rn3kk/RemoteTubeAmplifaier/py_server/ClientThread.py

import json
import logging
import time
from datetime import datetime

import errno
import socket
import sys
import traceback
import re
from threading import Thread

from common.common import *
from py_server import states
from py_server.TRX_State_TCP_Client import TRX_State_TCP_Client

log = logging.getLogger('root')

PORT_AUDIO = 6992


class ClientThread(Thread):
    __terminate = False

    def __init__(self, conn, addr, mech1, pins):
        log.debug('ClientControlThread()')
        Thread.__init__(self)
        self.__conn = conn
        self.__set_keep_alive(self.__conn)
        self.__conn.settimeout(0.1)
        self.__autorisation_token = ''
        self.__autorised = False
        self.__connection_time = datetime.now()
        self.__addr = addr
        self.__mech1 = mech1
        self.__mech2 = mech1
        self.__pins = pins
        self.__edit_mode = 0
        self.__trx_state_informer = TRX_State_TCP_Client.getInstance()

    def __del__(self):
        print('~ClientControlThread()')

    def run(self):
        log.debug('ClientControlThread is run')
        while not self.__terminate:
            time.sleep(0.001)
            if not self.__autorised \
                    and ((datetime.now() - self.__connection_time).total_seconds() * 1000 > 1000):
                log.error('client autorisation error')
                self.__conn.close()
                self.__client_disconnected()
                break
            try:
                data = self.__conn.recv(128)
                if self.__terminate:
                    break
                if len(data) == 0:
                    self.__conn.close()
                    self.__client_disconnected()
                    break
                s = re.compile(b"{.*?}")
                m = s.search(data)
                while m:
                    try:
                        data = data.replace(m.group(), b'')
                        cmd = json.loads(m.group())
                        if self.__autorised:
                            c = cmd[COMMAND]
                            if c == CMD_CHANGE_ANGLE_MECH1:
                                angle = int(cmd[VALUE])
                                self.__mech1.set_angle(angle)
                            elif c == CMD_CHANGE_ANGLE_MECH2:
                                angle = cmd[VALUE]
                                self.__mech2.set_angle(angle)
                            elif c == CMD_CHANGE_MANUAL_MECH1:
                                self.__mech1.set_manual_mode()
                            elif c == CMD_CHANGE_MANUAL_MECH2:
                                self.__mech2.set_manual_mode()
                            elif c == CMD_CHANGE_PWR:
                                self.__pins.change_pwr()
                            elif c == CMD_CHANGE_RELAY:
                                self.__pins.set_relay_number(int(cmd[VALUE]))
                            elif c == CMD_RESET_PROTECTION:
                                self.__pins.reset_protection()
                            elif c == CMD_CHANGE_BANDPATH:
                                self.__pins.change_bandpath()
                            elif c == CMD_EDIT_MODE:
                                if self.__trx_state_informer.trx_found == 0:
                                    self.__edit_mode = 0
                                    d = Protocol.createCmd(FROM_PA_EDIT_MODE, self.__edit_mode)
                                else:
                                    self.__edit_mode = int(not self.__edit_mode)
                                    log.debug(f'edit mode is {self.__edit_mode}')
                                    d = Protocol.createCmd(FROM_PA_EDIT_MODE, self.__edit_mode)
                                self.__conn.send(d)
                                if self.__edit_mode == 0:
                                    self.__mech1.disable_manual_mode()
                                else:
                                    freq = round_freq(self.__trx_state_informer.freq)
                                    self.__trx_state_informer.set_trx_freq(freq)
                            elif c == CMD_FREQ_UP:
                                if self.__edit_mode == 1:
                                    freq = self.__trx_state_informer.freq
                                    print('freq_trx = ', freq)
                                    freq = round_freq(self.__trx_state_informer.freq) + TUNE_STEP
                                    print('freq_round = ', freq)
                                    self.__trx_state_informer.set_trx_freq(freq)
                            elif c == CMD_FREQ_DOWN:
                                if self.__edit_mode == 1:
                                    freq = round_freq(self.__trx_state_informer.freq) - TUNE_STEP
                                    if freq < 0:
                                        freq = 0
                                    self.__trx_state_informer.set_trx_freq(freq)
                        elif cmd[COMMAND] == CMD_AUTORISATION_TOKEN:
                            print('to server autoorised')
                            self.__autorisation_token = cmd[VALUE]
                            self.__cleint_autorised()
                            log.info('client autorisation OK')
                        else:
                            log.warning('Unknown command ' + data.decode())
                    except:
                        print('error in data', data)
                    finally:
                        m = s.search(data)

            except socket.timeout:
                pass
            except Exception:
                print(traceback.format_exc())
                self.__conn.close()
                self.__conn = None
                log.error('close connection')
                self.__client_disconnected()
                break

            try:
                if self.__autorised:
                    pins_d = self.__pins.get_data()
                    if pins_d:
                        self.__conn.send(pins_d)
                    trx_state = self.__trx_state_informer.get_data()
                    if trx_state:
                        self.__conn.send(trx_state)
                    mech1_d = self.__mech1.get_data()
                    if mech1_d:
                        print('Send_mech', mech1_d)
                        self.__conn.send(mech1_d)
            except socket.timeout:
                pass
            except socket.error as e:
                log.error('socket.error' + str(e))
                if e.errno == errno.ECONNRESET:
                    self.__conn.close()
                    self.__conn = None
                    log.error('close connection')
                    self.__client_disconnected()
                    break
                else:
                    raise
        if self.__conn:
            self.__conn.close()
        self.__trx_state_informer.resetInstance()
        print('ClientControlThread loop is end')

    def __cleint_autorised(self):
        addr = self.__addr
        log.info('input connection from  ' + addr[0] + ' autorised')
        self.__autorised = True
        self.__pins.client_connected()
        self.__mech1.client_connected()
        self.__trx_state_informer.send_current_state()
        d = Protocol.createCmd(FROM_PA_EDIT_MODE, self.__edit_mode)
        self.__conn.send(d)

    def __client_disconnected(self):
        addr = self.__addr
        self.__edit_mode = False
        log.info('disconnected ' + addr[0])

    def __set_keep_alive(self, sock, after_idle_sec=1, interval_sec=5, max_fails=6):
        sock.setsockopt(socket.SOL_SOCKET, socket.SO_KEEPALIVE, 1)
        sock.setsockopt(socket.IPPROTO_TCP, socket.TCP_KEEPIDLE, after_idle_sec)
        sock.setsockopt(socket.IPPROTO_TCP, socket.TCP_KEEPINTVL, interval_sec)
        sock.setsockopt(socket.IPPROTO_TCP, socket.TCP_KEEPCNT, max_fails)

    def set_terminate(self):
        self.__terminate = True
