rn3kk/RemoteTubeAmplifaier/(commit log)

2020-04-17 -перемещение файло
2020-04-17 Подготовка к загрузке позиций частота полождения из файла
2020-04-17 Сделана загрузка точек из файла
2020-04-17 Добавлено генерация сигнала при изменении частоты
2020-04-17 Добавил пустой класс
2020-04-21 -добавлен файл для задания кофигурации, хрангения настроек,хранения точек, его парсинг -добавлен код по взаимодейтсвию с мотором (работает)
2020-04-28 В конфиг добавил разделы для мехадуино устройств
2020-04-30 -удалил лишние сущности, упростил систему -изменил конфиг
2020-04-30 начал делать gui
2020-05-30 -сделан парсинг чатоты, номера слайса, активного слайса, ТХ -не корректно работает парсинг, нужно удалить \n в передаваемом на парсинг массиве и удалить все что после него
2020-06-01 - сузил панель со слайсами - работает парсинг частоты, активного слайса, ТХ
2020-06-08 -добавил кнопки перестройки частоты -добавил кнопку Tune
2020-06-10 -добавлены в конфиг список частот -не работает задание позиционирования (нужно переделать на сигнал слоты) -частота передается четерь int
2020-06-14 -мехадуино панель теперь управляет мотором
2020-06-14 -протянул название в панель -изменил стиль панели
2020-06-16 -добавил разсылку событий о режиме настроек
2020-06-17 -когда включаем tune mode частота TX слайса автоматом подгоняется под сетку с шагом 25 кгц. -работает перестройка частоты трансивера по кнопкам < и >
2020-06-18 -сделано сохранение значение позиция + частота ( работает криво, нужно разбираться)
2020-06-20 -ввел режим tune mode -убрал привязку ГУИ к трансиверу -мехадуино ходит следом за частотой флекса -добавил включение/отключение крутилки для перестройки мехадуино в зависимости от режима ( tuneMode)
2020-07-11 -добавлен функционал для добавления протоколов других трансиверов (создан интерфейс) -добавлен пустой класс для поддкржки FT-857
2020-07-17 -добавлены новые секции в конфиг (но не сделан их парсинг) -добавлена пустая фабрика для получения интерфейса радио
2020-07-17 -напи сана фабрика для создания трансивера
2020-07-22 -Переход на создание радио через фабрику
2020-07-25 -сделано получение частоты от ft857 -частота пока не парсится, есть предположение что порядок байт приходит обратный
2020-07-26 -поддержана работа трансивера yaesu ft-857
2020-08-18 -сделал поддержку ручной настройки Mechaduino -ручное задание градусов не совпадает с заданием через указание точки (нужно править прошивку Mechaduino)
2020-12-05 работа на сервером;
2020-12-05 работа над моделью
2020-12-07 работа над протоколом
2020-12-26 Работа над сервером -поддаржан многоклиентский режим подключения
2020-12-26 Работа над сервером -добавлена проверка токена во входящих запросах
2020-12-26 Работа над сервером -после подключения сразу отдается модель
2020-12-26 Работа над клиентом -добавлена пустая форма
2020-12-29 Перенос файлов
2021-01-27 Работа над сервером -работает обмен данными
2021-04-07 Работа над широковещательной рассылкой инфы о себе. Не работает прием сообщений(принимает только первую датаграмму и все)
2021-04-08 Работает прием бродкастов
2021-04-10 Работа над рассылкой событий о появлении ум в локалке и приеме их на программе клиенте. Работает.
2021-04-12 Концепция такова, что наружу из локалки эти порты не высовываем, потому доверяем всем. Для подключения извне будет сервер.
2021-04-12 Работает автоматическое удаление услилтеля из списка у клиента, если его серверная часть выключилась
2021-04-13 Работа над методами подключения из клиента к серверу
2021-04-17 Работа над протоколом Нужно подумать как быть с передачей позиции для мехадуино
2021-04-18 Рабортает оповещение клиента если модель изменилась
2021-05-14 Работает подключение из клиента к серверу
2021-05-24 Работает получение частоты от сервера
2021-05-25 Работает передача и изменение состояния кнопки вклчения
2021-05-27 Работает передача состояние мехадуино от сервера клиенту
2021-05-28 Добавляются MechPanel на форму автоматически
2021-05-28 Работа над управлением мехадуино
2021-05-29 Разделил модель на две: BackModel, FrontModel. Общий для них класс Model хранит все состояния, а наследники реализуют поведение
2021-05-30 Наполнил функционалом BackModel,FrontModel
2021-06-24 Введение новой концепции моделей
2021-06-25 Работает подключение от клиента серверу с новыми моделями
2021-06-25 Поправил отображение кнопки Tune
2021-06-25 Работает -передача команды включения -закрытие формы если сервер отвалился -поправлены модели -работает нажатие кнопки включить
2021-06-28 -переделан механизм генерации соьытий при нажатии клавиш pwr tune mode -работает передача tunemode pwr
2021-06-28 -работает отправка новой позиции мехадуино на сервер
2021-06-29 -ведена сущность Mechaduino -в связи с этим изменились сигналы слоты везде
2021-06-29 -Добавил конструктор копирования в Mechaduino
2021-06-30 -Работает ГУИ по изменению мехадуино, включения, изменению режима тюне може , ручного изменения мехадуино
2021-06-30 -добавлен пустой класс для обслуживания пинов
2021-06-30 -убраны не используемые слоты
2021-07-05 Работает проброс данных на сервере через сигналы
2021-12-28 -убраны warnings
2021-12-28 Работа над сервером(конроллером) -удалено не нужное -упрощение кода: жестко прописываем два мотора
2021-12-29 -жестко прописаны два мехадуино на форме у клиента -при подключении клиента, происходит передача статуса усилителя -наведение порядка по коду клиента
2021-12-29 -работает проброс состояние кнопки включения на сервер и отрисовка состояния на клиенте
2022-03-16 Начат проект на питоне
2022-03-18 Создание каркаса сервера
2022-03-18 Создание GUI клиента
2022-03-18 -клиент подключается к серверу и авторизуется
2022-03-18 -мотор управляется с клиента( только градусы)
2022-03-19 добавил файлы
2022-03-19 - работа над GIU - работа над пинами
2022-03-19 - работа над пинами
2022-03-19 - промежуточный коммит
2022-03-21 - работает задание угла из клиента - работает задание ручного режима из клиента -работает сброс защиты -работает кнопка включения
2022-03-21 - работает задание реле - работает отображение какое релде там включено (после конекта)
2022-03-21 - работает режим включения/отключения редактирования параметров УМ
2022-07-02 - сервер подключается к радио и получает: частоту, включено или выключено радио
2022-07-07 Работает взаимодействие клинета и сервера - вкл откл -получение статуа радио и частоты -сброс защит -переключение bandpath
2022-07-07 - есть косяки управления мехадуино при быстрой перестройке на сервере
2022-07-08 - сделана остановка потокос по Ctrl-C - убрано спамящее логгирование - добавлено логгирование
2022-07-08 - добавлено логгирование
2022-07-11 - удаление файлов срр - работа над перестройкой частоты трх для настройки
2022-07-12 - работает перестройка по частоте для настройки радио
2026-10-13 - прошивка esp32: веб-морда с таблицей выбора частот - при выборе частоты меняется положение сервопривода - описание задачи в CLAUDE.md
2026-10-13 - сервоприводы STS3215: КПЕ и вариометр - режим настройки на веб-странице с сохранением положений для частоты - хранение настроек на microSD - переключатель БМЗ на 5 положений через реле - на страниц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
2026-10-14 - хранение настроек во внутренней flash-памяти вместо microSD - выгрузка и загрузка таблицы настроек через веб-страницу - сервисный режим: поиск сервоприводов на шине и смена ID - чтение ответов серв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
2026-10-14 - модуль реле: включение УМ, плавный пуск через 5 с, прогрев 3 мин с блокировкой управления, анодное после прогрева - разрешение PTT с запретом при защите, отсутствии анодного и на время переключения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
2026-10-15 - переключатель БМЗ на третьем сервоприводе: 5 положений, поворот кратчайшим путём в шаговом режиме, калибровка положения 1, PTT снимается на время поворота - реле 3..7 освобождены - README на русско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
2026-10-16 - PTT трансивера через ESP32 (вход IO11), реле 8 - PTT усилителя - охлаждение 5 мин после передачи: выключение раньше только кнопкой "выключить без охлаждения" - веб-страница вынесена в файлы LittleF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
2026-10-16 - скрипт tools/flash.sh: сборка, заливка прошивки и файлов веб-страницы, монитор порта - передача с веб-страницы только при включённом и прогретом усилителе - передача с веб-страницы учитывается для 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
2026-10-16 - ползунок положения привода переключателя БМЗ в сервисе для калибровки - колесо мыши двигает ползунок под курсором (10 шагов, с Shift - 1)
2026-10-22 - убрана проверка наличия анодного (вход IO46), реле анодного осталось - плавный пуск автономный в усилителе: реле 2 (IO10) и этап плавного пуска удалены, прогрев сразу после включения - диапазон 190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
2026-10-26 - шина сервоприводов через Waveshare Bus Servo Adapter (A): TX на IO47, RX на IO21 (пины поменяны местами, проверено с приводом ID 1) - без привода переключателя БМЗ точка сохраняется с БМЗ "не задан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
2026-10-26 - README (ru/en) и схема подключения: шина сервоприводов через адаптер Waveshare Bus Servo Adapter (A) вместо резистора, TX на IO47, RX на IO21, перемычки A, питание приводов 12 В
2026-10-26 - передача запрещена на время перестройки по выбору частоты (КПЕ, вариометр), при отсутствии связи с приводом и если привод не встал; ручное вращение в режиме настройки PTT не снимает - плашка на стр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
2026-10-27 - переключатель БМЗ в многооборотном режиме вместо шагового: в шаговом режиме привод не сообщает угол; цель со счётом оборотов в окне -1..+2 оборота, кратчайший путь через ноль - режим привода настра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
2026-10-27 - счёт оборотов привода переключателя БМЗ сбрасывается после каждого поворота (режим 3 -> 0 только в ОЗУ привода): путь всегда кратчайший, 5 -> 1 через ноль - многооборотный режим включается только в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
2026-10-27 - руководство пользователя в LaTeX (docs/manual/manual.tex) и PDF: сборка, установка программы, первый запуск, настройка частот, работа, неисправности - docs/manual/build.sh: сборка PDF - README: ссы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
2026-10-27 - CLAUDE.md: сводка договорённостей с пользователем, текущее направление (три привода, адаптер шины, руководство), задача 13 - руководство пользователя - README: сервоприводы проверены на плате, реле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
2026-10-27 - руководство пользователя: заказ комплекта по почте bi4remote@mail.ru (первая страница и раздел "Детали")
2026-11-02 Теперь угол БМЗ 360 градусов
2026-11-03 Поправлен Readme
